Tolga-Cav/USB-Control-Panel-v1/PCB/Buttons/production/bom.csv

Designator | Footprint | Quantity | Value | LCSC Part #
C1, C2, C3, C4, C5, C6 | 1206 | 6 | 1uf
J1 | PinHeader_2x11_P2.54mm_Vertical | 1 | Conn_02x11_Odd_Even
S1, S2, S3, S4, S5, S6 | ULP12OAP1RSSCL1REDGRN | 6 | ULP12OAP1RSSCL1REDGRN
