Tolga-Cav/USB-Control-Panel-v1/PCB/Encoders/production/bom.csv

Designator | Footprint | Quantity | Value | LCSC Part #
J1 | PinHeader_1x05_P2.54mm_Vertical | 1 | Conn_01x05
U1, U2 | PEC12R4125FN0012 | 2 | PEC12R-4125F-N0012
