Tolga-Cav/USB-Control-Panel-v1/PCB/Main_Panel/production/bom.csv

Quantity | Value | Designator | Footprint | LCSC Part #
4 | 0.01uF | C1, C2, C3, C4 | 0805 | C1710
1 | TCA6424ARGJR | IC1 | QFN50P500X500X60-33N-D | C80692
12 | 10k | R1, R2, R3, R30, R31, R32, R33, R34, R35, R36, R37, R4 | 0805 | C17414
1 | 2.4k | R5 | 0805 | C17526
1 | TLC5947DAP | U2 | HTSSOP-32-1EP_6.1x11mm_P0.65mm_EP5.2x11mm_Mask4.11x4.36mm_ThermalVias | C2873022
