Tolga-Cav/USB-Control-Panel-v1/(list of files, cad)

Other CAD files:
CAD/3rd_Party_Parts/91862A525_Hex Panel Nut.ipt
CAD/3rd_Party_Parts/Bumpers.ipt
CAD/3rd_Party_Parts/Encoder_Knob.ipt
CAD/3rd_Party_Parts/Lighted_Buttons/Body1.ipt
CAD/3rd_Party_Parts/Lighted_Buttons/Body10.ipt
CAD/3rd_Party_Parts/Lighted_Buttons/Body2.ipt
CAD/3rd_Party_Parts/Lighted_Buttons/Body3.ipt
CAD/3rd_Party_Parts/Lighted_Buttons/Body4.ipt
CAD/3rd_Party_Parts/Lighted_Buttons/Body5.ipt
CAD/3rd_Party_Parts/Lighted_Buttons/Body6.ipt
CAD/3rd_Party_Parts/Lighted_Buttons/Body7.ipt
CAD/3rd_Party_Parts/Lighted_Buttons/Body8.ipt
CAD/3rd_Party_Parts/Lighted_Buttons/Body9.ipt
CAD/3rd_Party_Parts/Lighted_Buttons/Lighted_Buttons.iam
CAD/3rd_Party_Parts/Momentary Switch.ipt
CAD/3rd_Party_Parts/On-On Switch.ipt
CAD/3rd_Party_Parts/PDB12-H4201-103BF/PDB12-H4201-103BF.iam
CAD/3rd_Party_Parts/PDB12-H4201-103BF/µç×èÆ¬.ipt
CAD/3rd_Party_Parts/PDB12-H4201-103BF/¶Ë×Ó.ipt
CAD/3rd_Party_Parts/PDB12-H4201-103BF/Íâ¿Ç.ipt
CAD/3rd_Party_Parts/PDB12-H4201-103BF/ÖáÐÄ.ipt
CAD/3rd_Party_Parts/PEC12R-4125F-N0012.ipt
CAD/3rd_Party_Parts/Potentiometer Knob.ipt
CAD/3rd_Party_Parts/Switch Guard.ipt
CAD/Box.ipt
CAD/Buttons_PCB/Buttons.iam
CAD/Buttons_PCB/Buttons_PCB.ipt
CAD/Buttons_PCB/Buttons_copper.ipt
CAD/Buttons_PCB/Buttons_pad.ipt
CAD/Buttons_PCB/Buttons_silkscreen.ipt
CAD/Buttons_PCB/Buttons_soldermask.ipt
CAD/Buttons_PCB/Buttons_via.ipt
CAD/Encoders_PCB/Encoders.iam
CAD/Encoders_PCB/Encoders_PCB.ipt
CAD/Encoders_PCB/Encoders_copper.ipt
CAD/Encoders_PCB/Encoders_pad.ipt
CAD/Encoders_PCB/Encoders_silkscreen.ipt
CAD/Encoders_PCB/Encoders_soldermask.ipt
CAD/Faceplate.ipt
CAD/Full_Assembly.iam
CAD/Magnetic Faceplate Base.ipt
CAD/Magnetic Faceplate Top.ipt
CAD/Main_Panel_PCB/Main_Panel.iam
CAD/Main_Panel_PCB/Main_Panel_PCB.ipt
CAD/Main_Panel_PCB/Main_Panel_copper.ipt
CAD/Main_Panel_PCB/Main_Panel_silkscreen.ipt
CAD/Main_Panel_PCB/Main_Panel_soldermask.ipt
CAD/Main_Panel_PCB/Main_Panel_via.ipt
CAD/OldVersions/Box.0036.ipt
CAD/OldVersions/Faceplate.0027.ipt
CAD/OldVersions/Full_Assembly.0060.iam
CAD/OldVersions/Magnetic Faceplate Base.0038.ipt
CAD/OldVersions/Magnetic Faceplate Top.0039.ipt
CAD/Potentiometers_PCB/Potentiometers.iam
CAD/Potentiometers_PCB/Potentiometers_PCB.ipt
CAD/Potentiometers_PCB/Potentiometers_copper.ipt
CAD/Potentiometers_PCB/Potentiometers_pad.ipt
CAD/Potentiometers_PCB/Potentiometers_silkscreen.ipt
CAD/Potentiometers_PCB/Potentiometers_soldermask.ipt
CAD/Spacers/Button Spacer.ipt
CAD/Spacers/Encoder Spacer.ipt
CAD/Spacers/Header Spacers/Button Header Spacer 1.ipt
CAD/Spacers/Header Spacers/Encoder Header Spacer 1.ipt
CAD/Spacers/Header Spacers/OldVersions/Button Header Spacer 1.0002.ipt
CAD/Spacers/Header Spacers/OldVersions/Encoder Header Spacer 1.0001.ipt
CAD/Spacers/Header Spacers/OldVersions/Potentiometer Header Spacer 1.0001.ipt
CAD/Spacers/Header Spacers/Potentiometer Header Spacer 1.ipt
CAD/Spacers/M3 4mm Generic Standoff.ipt
CAD/Spacers/OldVersions/Button Header Spacer.0001.ipt
CAD/Spacers/OldVersions/Button Spacer.0004.ipt
CAD/Spacers/OldVersions/Encoder Spacer.0007.ipt
CAD/Spacers/OldVersions/Potentiometer Spacer.0005.ipt
CAD/Spacers/Potentiometer Spacer.ipt
CAD/Switches_PCB/Switches.iam
CAD/Switches_PCB/Switches_PCB.ipt
CAD/Switches_PCB/Switches_copper.ipt
CAD/Switches_PCB/Switches_pad.ipt
CAD/Switches_PCB/Switches_silkscreen.ipt
CAD/Switches_PCB/Switches_soldermask.ipt
