Tolga-Cav/USB-Control-Panel-v1/PCB/Main_Panel/Main_Panel.kicad_pcb

## KiCad design PCB/Main_Panel/Main_Panel.kicad_pcb (2025-12-21)

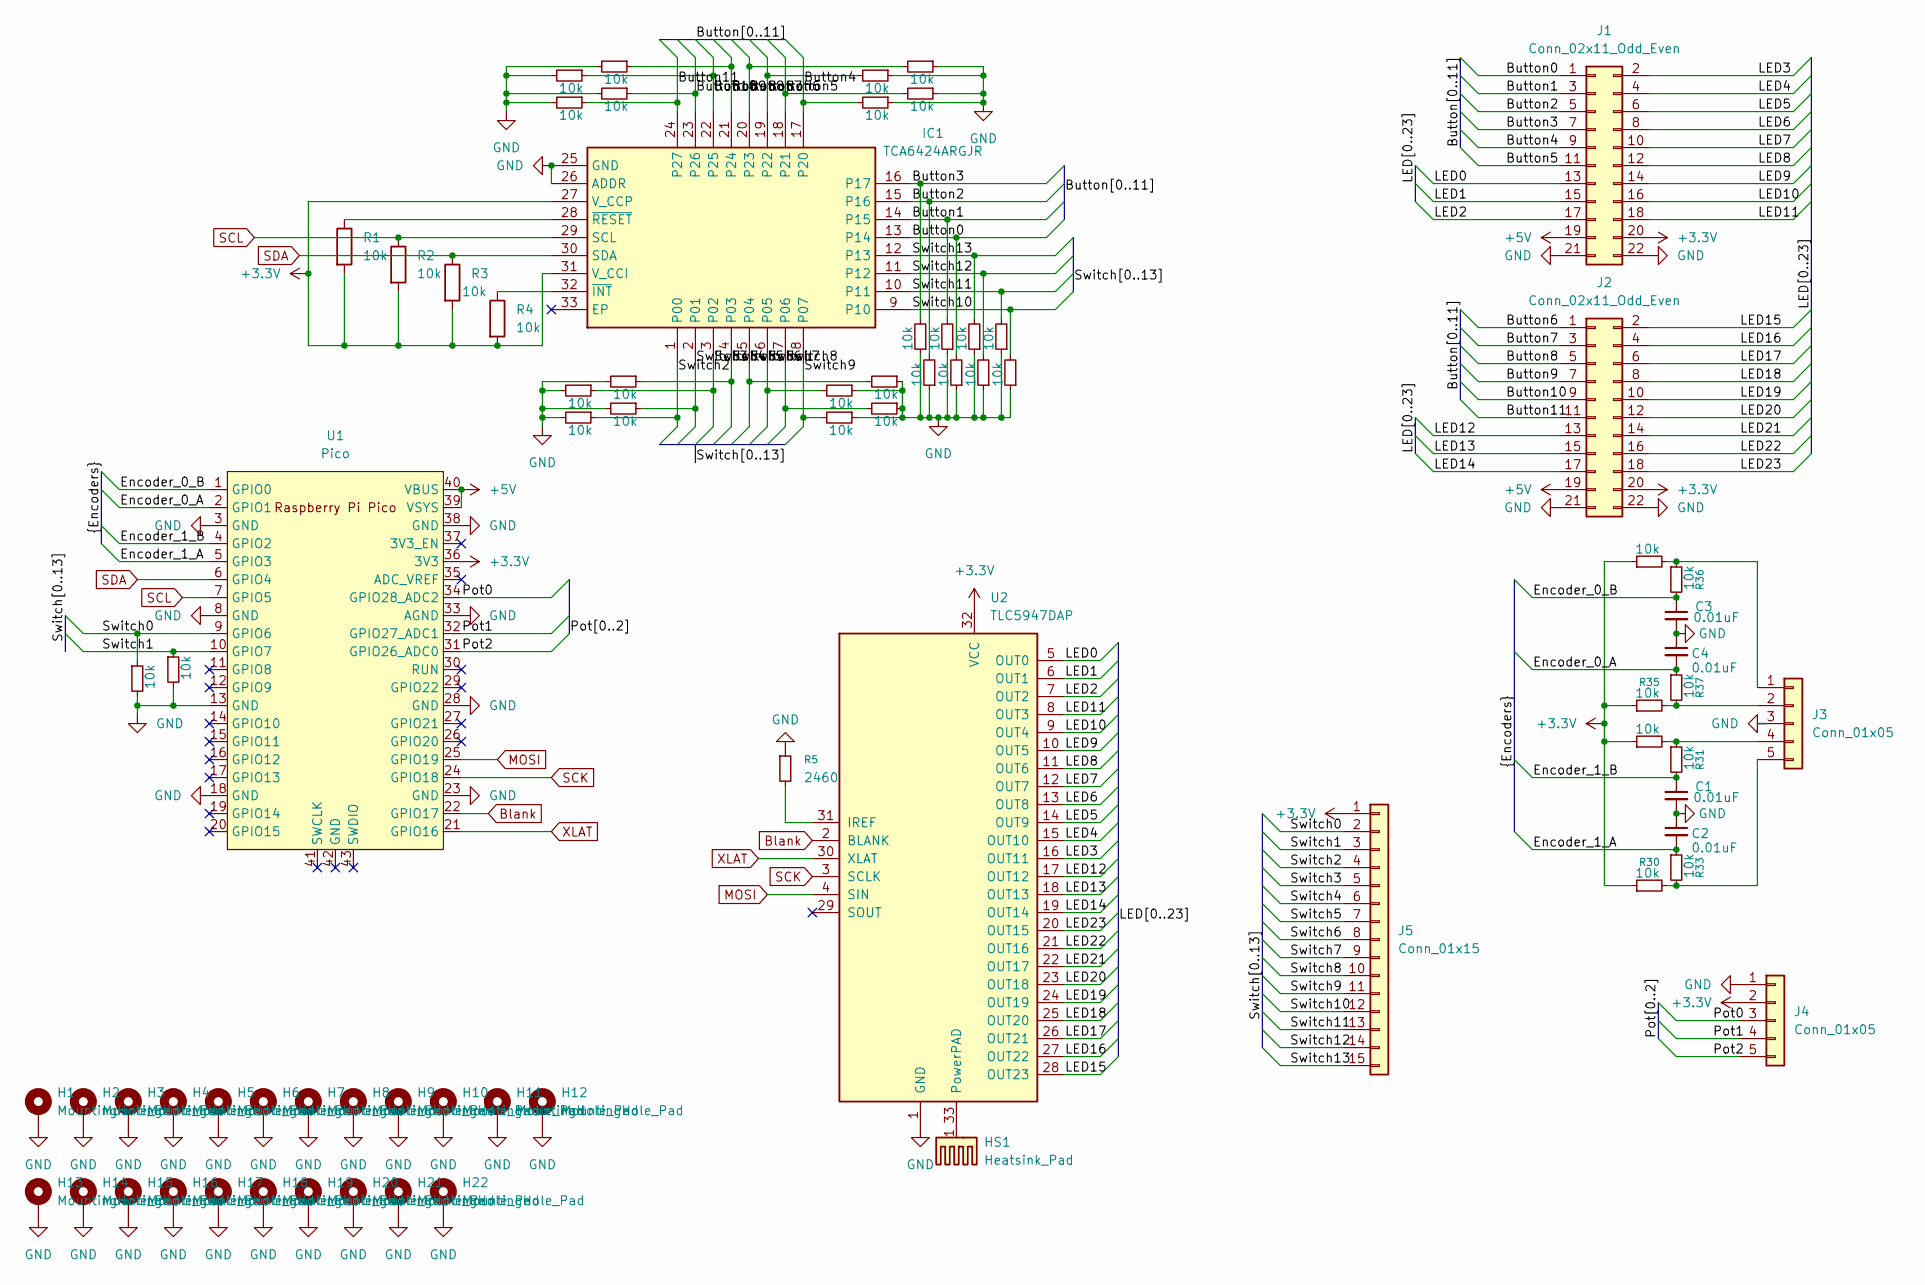
[picture p1: schematic Main_Panel.kicad_sch]

Parts:
C1, C2, C3, C4: 0.01uF; C_0805_2012Metric
H1, H2, H3, H4, H5, H6, H7, H8, H9, H10, H11, H12, H13, H14, H15, H16, H17, H18, H19, H20, H21, H22: MountingHole_Pad; MountingHole_3.2mm_M3_DIN965_Pad
HS1: Heatsink_Pad; Heat Sink
IC1: TCA6424ARGJR; QFN50P500X500X60-33N-D; Mouser Part Number 595-TCA6424ARGJR
J1, J2: Conn_02x11_Odd_Even; PinHeader_2x11_P2.54mm_Vertical
J3, J4: Conn_01x05; PinHeader_1x05_P2.54mm_Vertical
J5: Conn_01x15; PinHeader_1x15_P2.54mm_Vertical
R1, R2, R3, R4, R6, R7, R8, R9, R10, R11, R12, R13, R14, R15, R16, R17, R18, R19, R20, R21, R22, R23, R24, R25, R26, R27, R28, R29, R30, R31, R32, R33, R34, R35, R36, R37, R38, R39: 10k; R_0805_2012Metric
R5: 2460; R_0805_2012Metric
U1: Pico; RPi_Pico_SMD_TH
U2: TLC5947DAP; HTSSOP-32-1EP_6.1x11mm_P0.65mm_EP5.2x11mm_Mask4.11x4.36mm_T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

Connections:
+3.3V: IC1.27 (V_CCP), IC1.31 (V_CCI), J1.20, J2.20, J4.2, J5.1, R1.2, R2.2, R3.2, R4.2, R30.1, R32.1, R34.1, R35.1, U1.36 (3V3), U2.32 (VCC)
+5V: J1.19, J2.19, U1.39 (VSYS), U1.40 (VBUS)
/Button0: IC1.13 (P14), J1.1, R10.2
/Button1: IC1.14 (P15), J1.3, R7.2
/Button2: IC1.15 (P16), J1.5, R9.2
/Button3: IC1.16 (P17), J1.7, R6.2
/Button4: IC1.17 (P20), J1.9, R19.2
/Button5: IC1.18 (P21), J1.11, R21.2
/Button6: IC1.19 (P22), J2.1, R18.2
/Button7: IC1.20 (P23), J2.3, R20.2
/Button8: IC1.21 (P24), J2.5, R15.1
/Button9: IC1.22 (P25), J2.7, R14.1
/Button10: IC1.23 (P26), J2.9, R16.1
/Button11: IC1.24 (P27), J2.11, R17.1
/Encoder_0_A: C4.2, R37.1, U1.2 (GPIO1)
/Encoder_0_B: C3.1, R36.2, U1.1 (GPIO0)
/Encoder_1_A: C2.2, R33.1, U1.5 (GPIO3)
/Encoder_1_B: C1.1, R31.2, U1.4 (GPIO2)
/LED0: J1.13, U2.5 (OUT0)
/LED1: J1.15, U2.6 (OUT1)
/LED2: J1.17, U2.7 (OUT2)
/LED3: J1.2, U2.16 (OUT11)
/LED4: J1.4, U2.15 (OUT10)
/LED5: J1.6, U2.14 (OUT9)
/LED6: J1.8, U2.13 (OUT8)
/LED7: J1.10, U2.12 (OUT7)
/LED8: J1.12, U2.11 (OUT6)
/LED9: J1.14, U2.10 (OUT5)
/LED10: J1.16, U2.9 (OUT4)
/LED11: J1.18, U2.8 (OUT3)
/LED12: J2.13, U2.17 (OUT12)
/LED13: J2.15, U2.18 (OUT13)
/LED14: J2.17, U2.19 (OUT14)
/LED15: J2.2, U2.28 (OUT23)
/LED16: J2.4, U2.27 (OUT22)
/LED17: J2.6, U2.26 (OUT21)
/LED18: J2.8, U2.25 (OUT20)
/LED19: J2.10, U2.24 (OUT19)
/LED20: J2.12, U2.23 (OUT18)
/LED21: J2.14, U2.22 (OUT17)
/LED22: J2.16, U2.21 (OUT16)
/LED23: J2.18, U2.20 (OUT15)
/Pot0: J4.3, U1.34 (GPIO28_ADC2)
/Pot1: J4.4, U1.32 (GPIO27_ADC1)
/Pot2: J4.5, U1.31 (GPIO26_ADC0)
/Switch0: J5.2, R38.1, U1.9 (GPIO6)
/Switch1: J5.3, R39.1, U1.10 (GPIO7)
/Switch2: IC1.1 (P00), J5.4, R23.1
/Switch3: IC1.2 (P01), J5.5, R25.1
/Switch4: IC1.3 (P02), J5.6, R22.1
/Switch5: IC1.4 (P03), J5.7, R24.1
/Switch6: IC1.5 (P04), J5.8, R28.2
/Switch7: IC1.6 (P05), J5.9, R26.2
/Switch8: IC1.7 (P06), J5.10, R29.2
/Switch9: IC1.8 (P07), J5.11, R27.2
/Switch10: IC1.9 (P10), J5.12, R13.2
/Switch11: IC1.10 (P11), J5.13, R12.2
/Switch12: IC1.11 (P12), J5.14, R11.2
/Switch13: IC1.12 (P13), J5.15, R8.2
Blank: U1.22 (GPIO17), U2.2 (BLANK)
GND: C1.2, C2.1, C3.2, C4.1, H1.1, H2.1, H3.1, H4.1, H5.1, H6.1, H7.1, H8.1, H9.1, H10.1, H11.1, H12.1, H13.1, H14.1, H15.1, H16.1, H17.1, H18.1, H19.1, H20.1, H21.1, H22.1, IC1.25 (GND), IC1.26 (ADDR), J1.21, J1.22, J2.21, J2.22, J3.3, J4.1, R5.1, R6.1, R7.1, R8.1, R9.1, R10.1, R11.1, R12.1, R13.1, R14.2, R15.2, R16.2, R17.2, R18.1, R19.1, R20.1, R21.1, R22.2, R23.2, R24.2, R25.2, R26.1, R27.1, R28.1, R29.1, R38.2, R39.2, U1.3 (GND), U1.8 (GND), U1.13 (GND), U1.18 (GND), U1.23 (GND), U1.28 (GND), U1.33 (AGND), U1.38 (GND), U2.1 (GND)
MOSI: U1.25 (GPIO19), U2.4 (SIN)
unnamed: IC1.32 (~INT), R4.1
unnamed: IC1.28 (~RESET), R1.1
unnamed: J3.1, R34.2, R36.1
unnamed: J3.2, R35.2, R37.2
unnamed: J3.4, R31.1, R32.2
unnamed: J3.5, R30.2, R33.2
unnamed: R5.2, U2.31 (IREF)
unnamed: HS1.1, U2.33 (PowerPAD)
SCK: U1.24 (GPIO18), U2.3 (SCLK)
SCL: IC1.29 (SCL), R2.1, U1.7 (GPIO5)
SDA: IC1.30 (SDA), R3.1, U1.6 (GPIO4)
XLAT: U1.21 (GPIO16), U2.30 (XLAT)

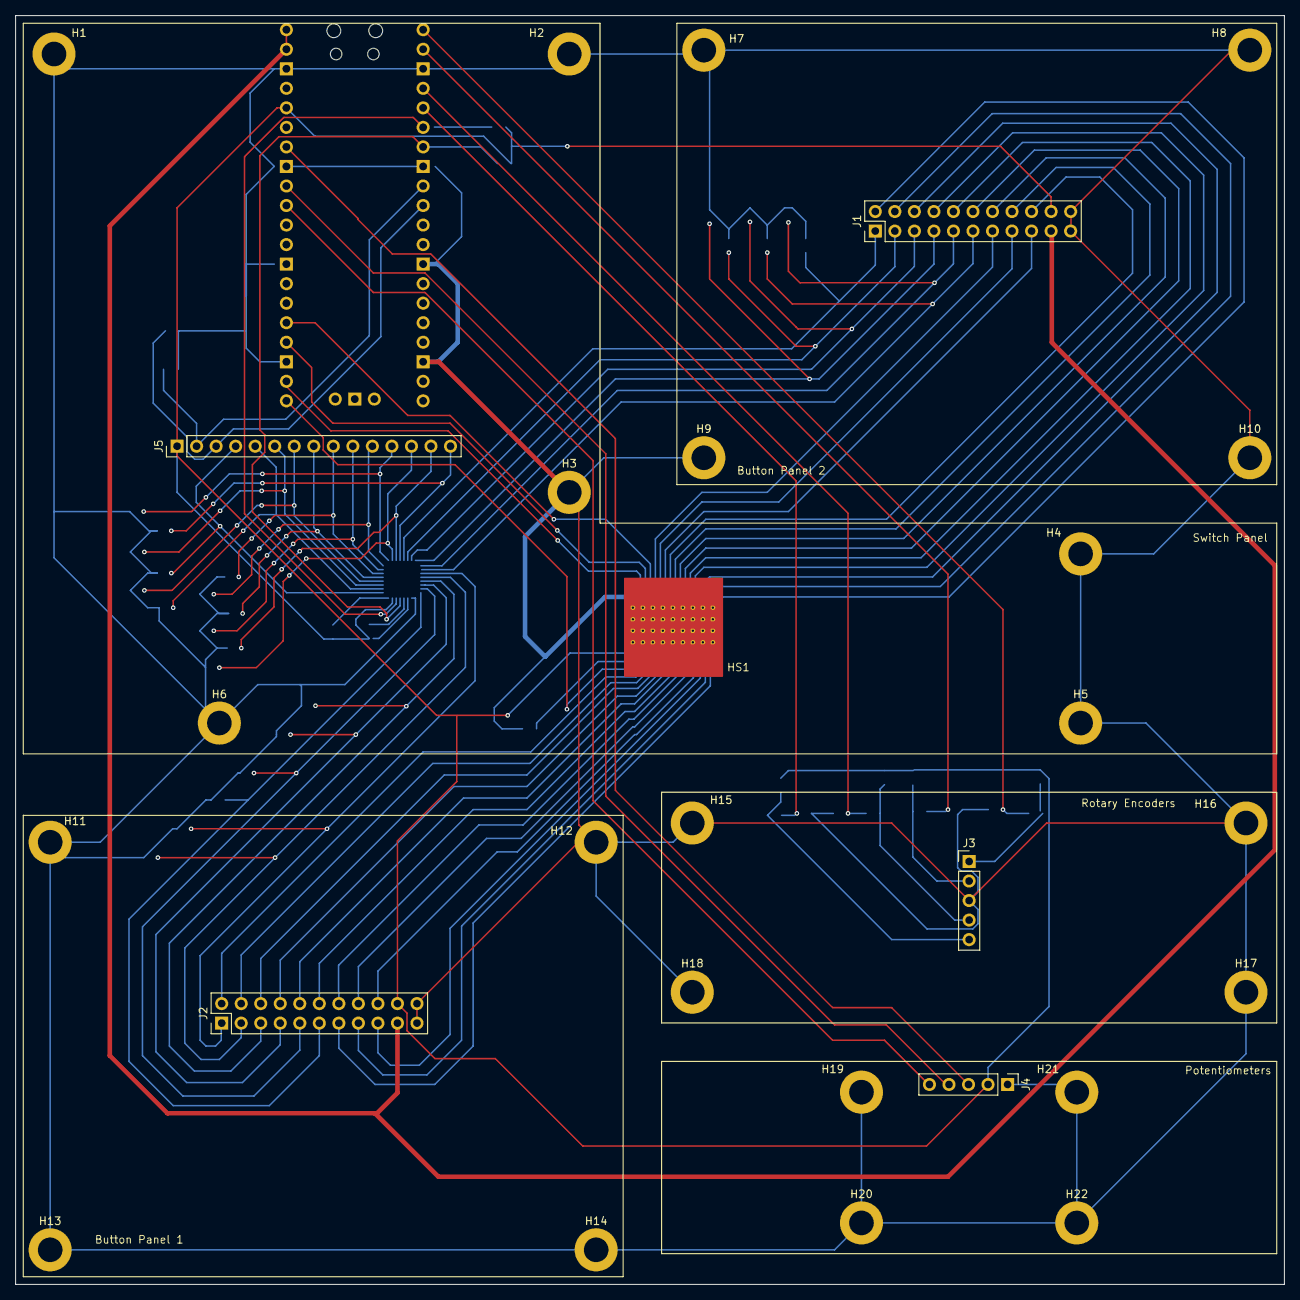
[picture p2: board Main_Panel.kicad_pcb from above]

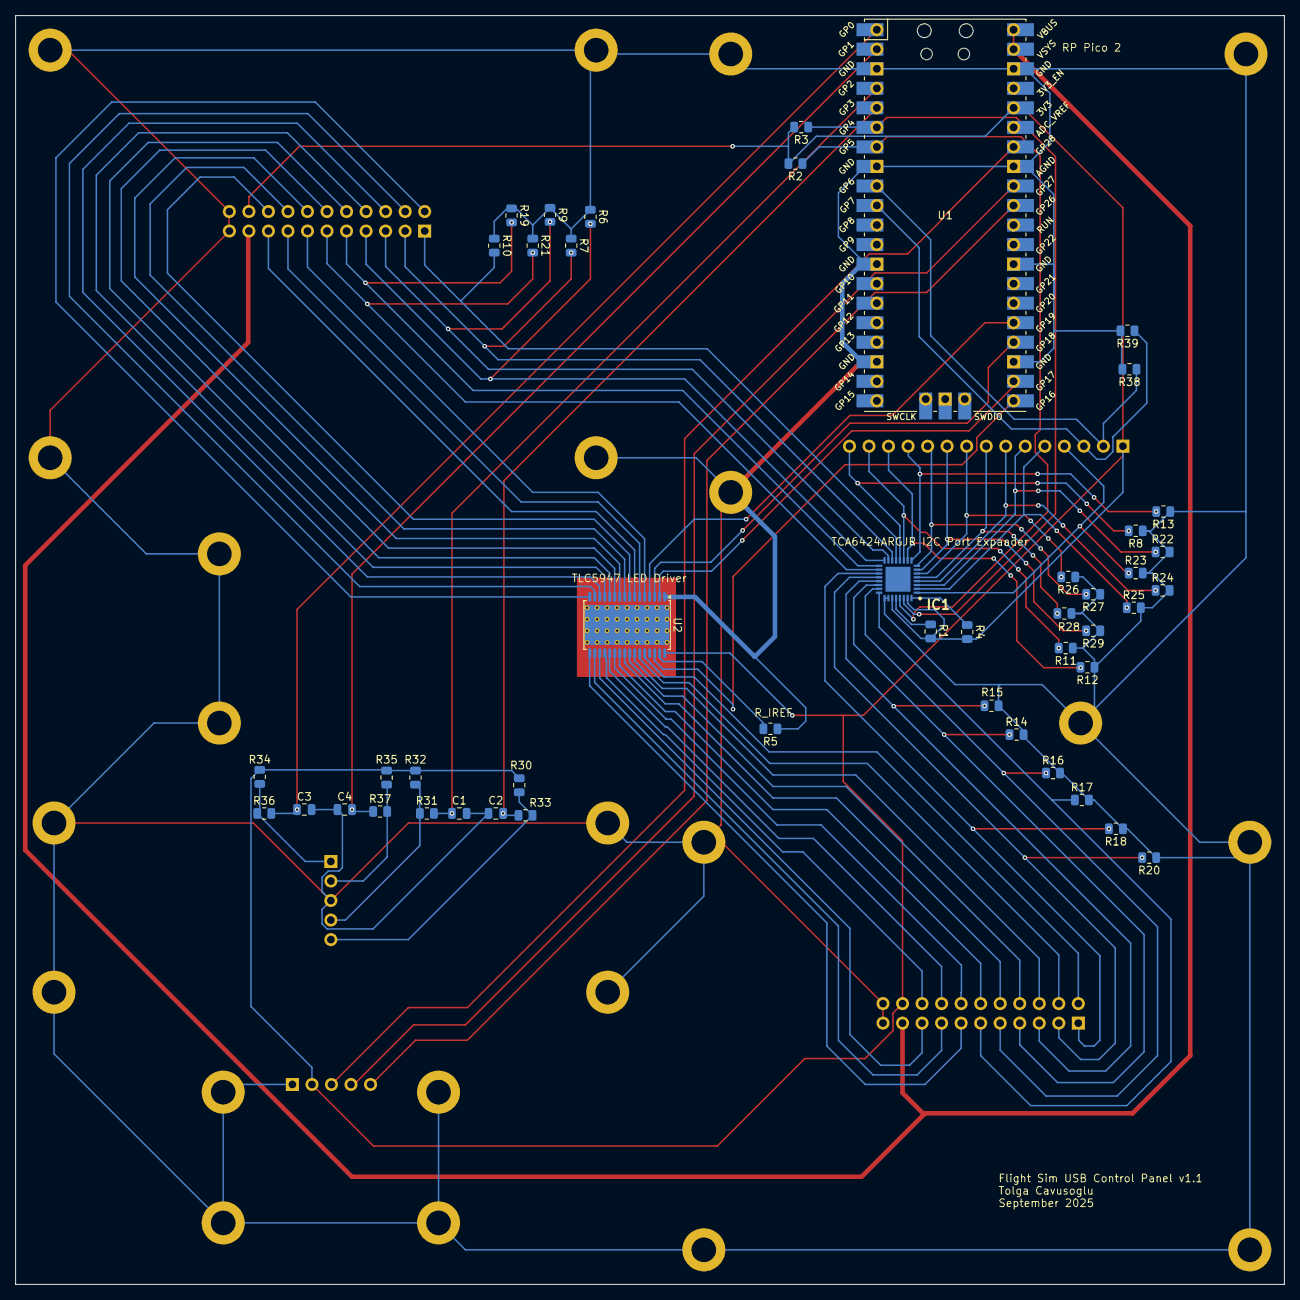
[picture p3: board Main_Panel.kicad_pcb from below]

Board: 2 copper layers, 165.0 x 165.0 mm, 74 parts (46 on the bottom side), 74 nets.
