Tolga-Cav/USB-Control-Panel-v1/PCB/Potentiometers/Potentiometers.kicad_pcb

## KiCad design PCB/Potentiometers/Potentiometers.kicad_pcb (2025-12-19)

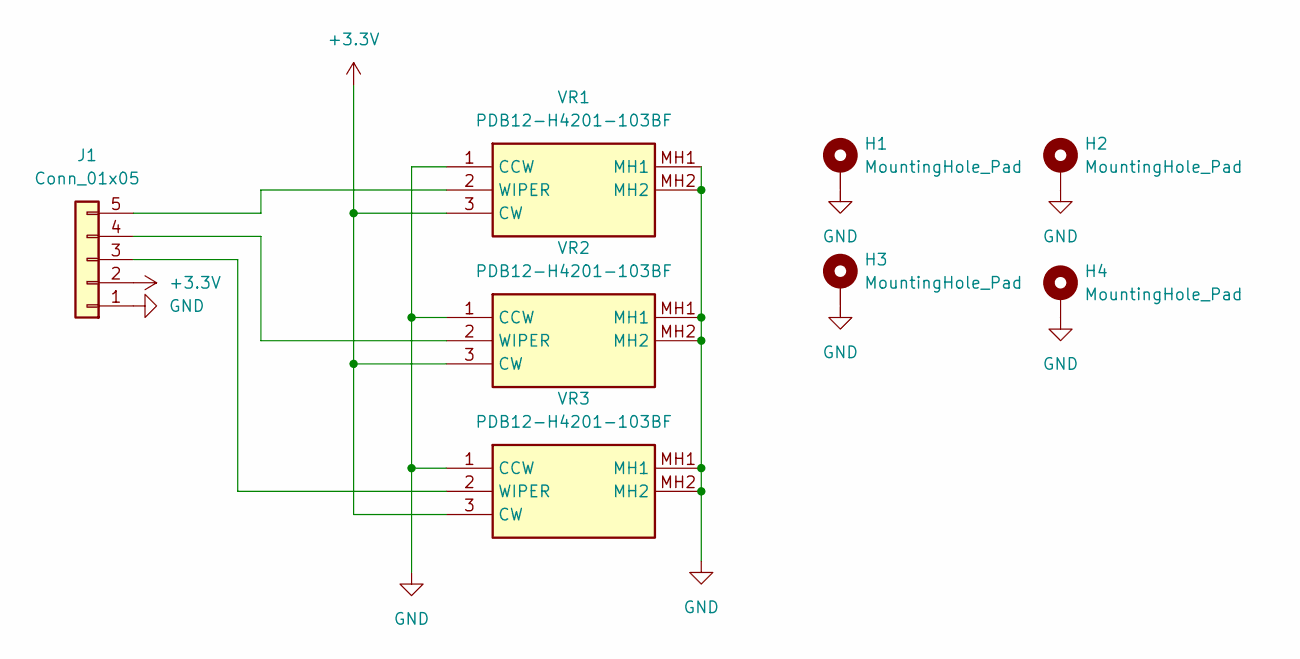
[picture p4: schematic Potentiometers.kicad_sch]

Parts:
H1, H2, H3, H4: MountingHole_Pad; MountingHole_3.2mm_M3_DIN965_Pad
J1: Conn_01x05; PinSocket_1x05_P2.54mm_Vertical
VR1, VR2, VR3: PDB12-H4201-103BF; PDB12H4201103BF; Mouser Part Number 652-PDB12-H4201103BF

Connections:
+3.3V: J1.2, VR1.3 (CW), VR2.3 (CW), VR3.3 (CW)
GND: H1.1, H2.1, H3.1, H4.1, J1.1, VR1.1 (CCW), VR1.MH1, VR1.MH2, VR2.1 (CCW), VR2.MH1, VR2.MH2, VR3.1 (CCW), VR3.MH1, VR3.MH2
unnamed: J1.3, VR3.2 (WIPER)
unnamed: J1.4, VR2.2 (WIPER)
unnamed: J1.5, VR1.2 (WIPER)

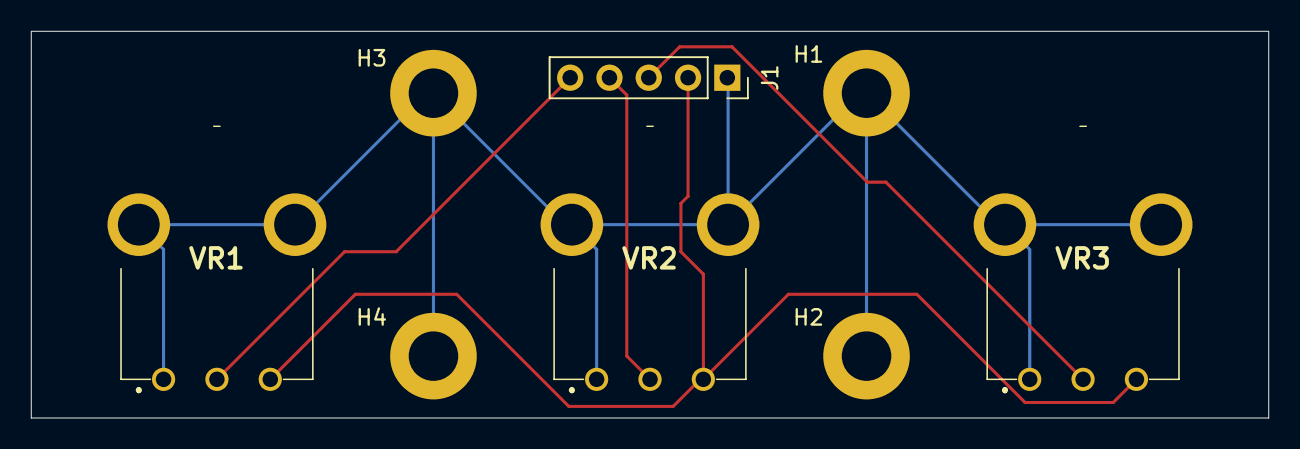
[picture p5: board Potentiometers.kicad_pcb from above]

Board: 2 copper layers, 80.0 x 25.0 mm, 8 parts (0 on the bottom side), 5 nets.
