Tolga-Cav/USB-Control-Panel-v1/PCB/Buttons/Buttons.kicad_pcb

## KiCad design PCB/Buttons/Buttons.kicad_pcb (2025-12-18)

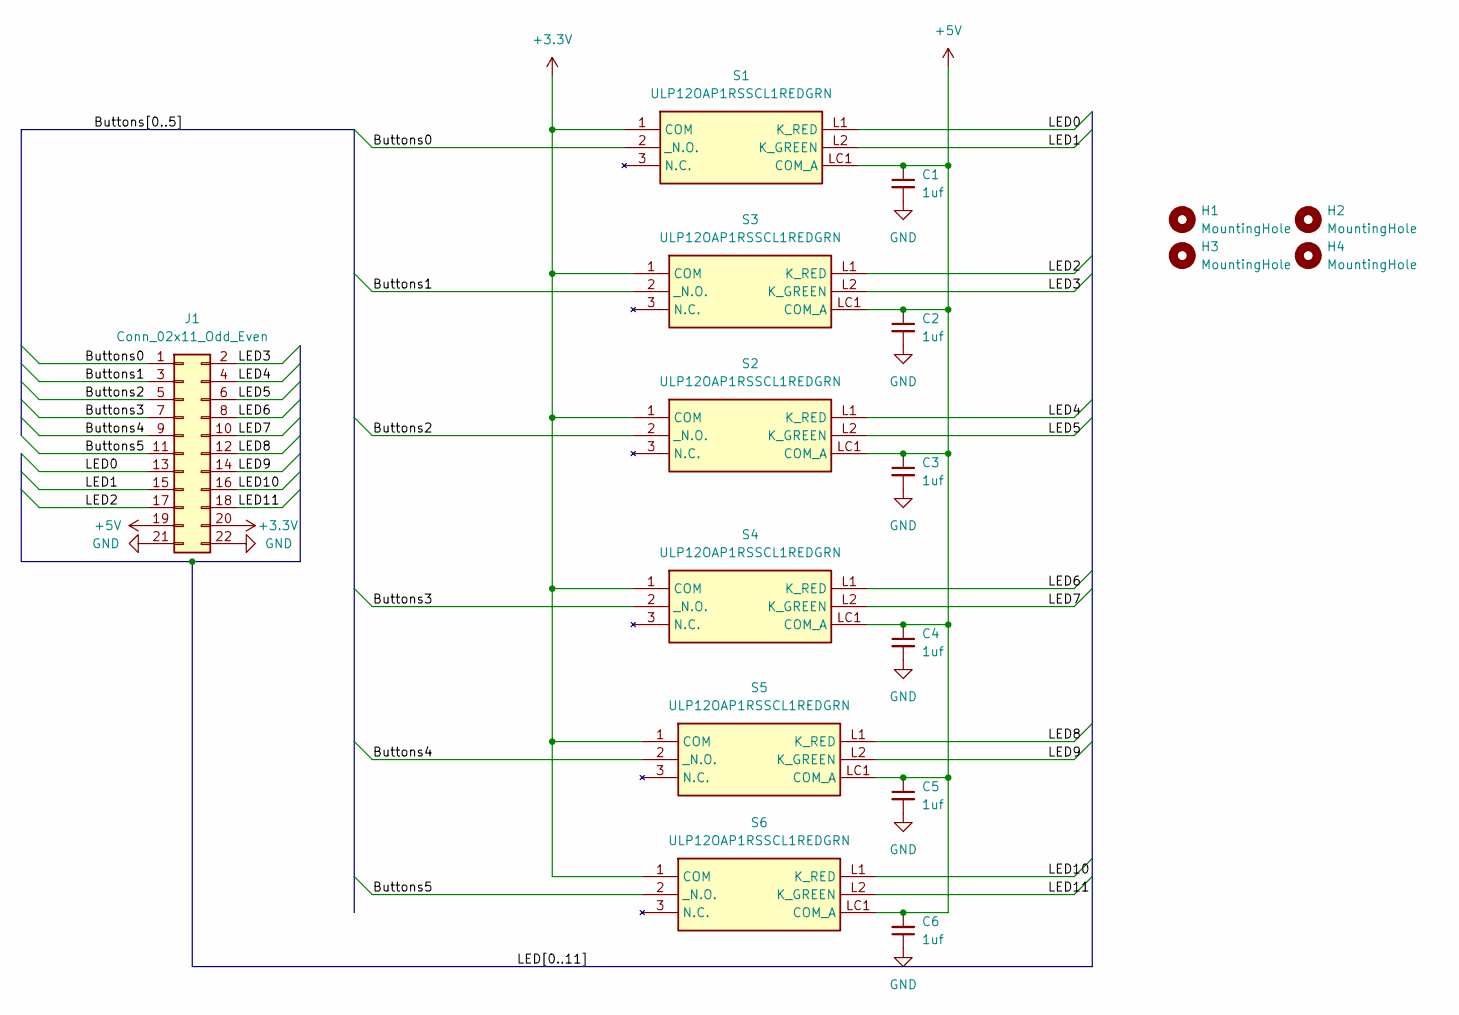
[picture p6: schematic Buttons.kicad_sch]

Parts:
C1, C2, C3, C4, C5, C6: 1uf; C_1206_3216Metric_Pad1.33x1.80mm_HandSolder
H1, H2, H3, H4: MountingHole; MountingHole_3.2mm_M3
J1: Conn_02x11_Odd_Even; PinHeader_2x11_P2.54mm_Vertical
S1, S2, S3, S4, S5, S6: ULP12OAP1RSSCL1REDGRN; Mouser Part Number 612-UP1RSSCL1REDGRN

Connections:
+3.3V: J1.20, S1.1 (COM), S2.1 (COM), S3.1 (COM), S4.1 (COM), S5.1 (COM), S6.1 (COM)
+5V: C1.1, C2.1, C3.1, C4.1, C5.1, C6.2, J1.19, S1.LC1 (COM_A), S2.LC1 (COM_A), S3.LC1 (COM_A), S4.LC1 (COM_A), S5.LC1 (COM_A), S6.LC1 (COM_A)
/Buttons0: J1.1, S1.2 (_N.O.)
/Buttons1: J1.3, S3.2 (_N.O.)
/Buttons2: J1.5, S2.2 (_N.O.)
/Buttons3: J1.7, S4.2 (_N.O.)
/Buttons4: J1.9, S5.2 (_N.O.)
/Buttons5: J1.11, S6.2 (_N.O.)
/LED0: J1.13, S1.L1 (K_RED)
/LED1: J1.15, S1.L2 (K_GREEN)
/LED2: J1.17, S3.L1 (K_RED)
/LED3: J1.2, S3.L2 (K_GREEN)
/LED4: J1.4, S2.L1 (K_RED)
/LED5: J1.6, S2.L2 (K_GREEN)
/LED6: J1.8, S4.L1 (K_RED)
/LED7: J1.10, S4.L2 (K_GREEN)
/LED8: J1.12, S5.L1 (K_RED)
/LED9: J1.14, S5.L2 (K_GREEN)
/LED10: J1.16, S6.L1 (K_RED)
/LED11: J1.18, S6.L2 (K_GREEN)
GND: C1.2, C2.2, C3.2, C4.2, C5.2, C6.1, J1.21, J1.22

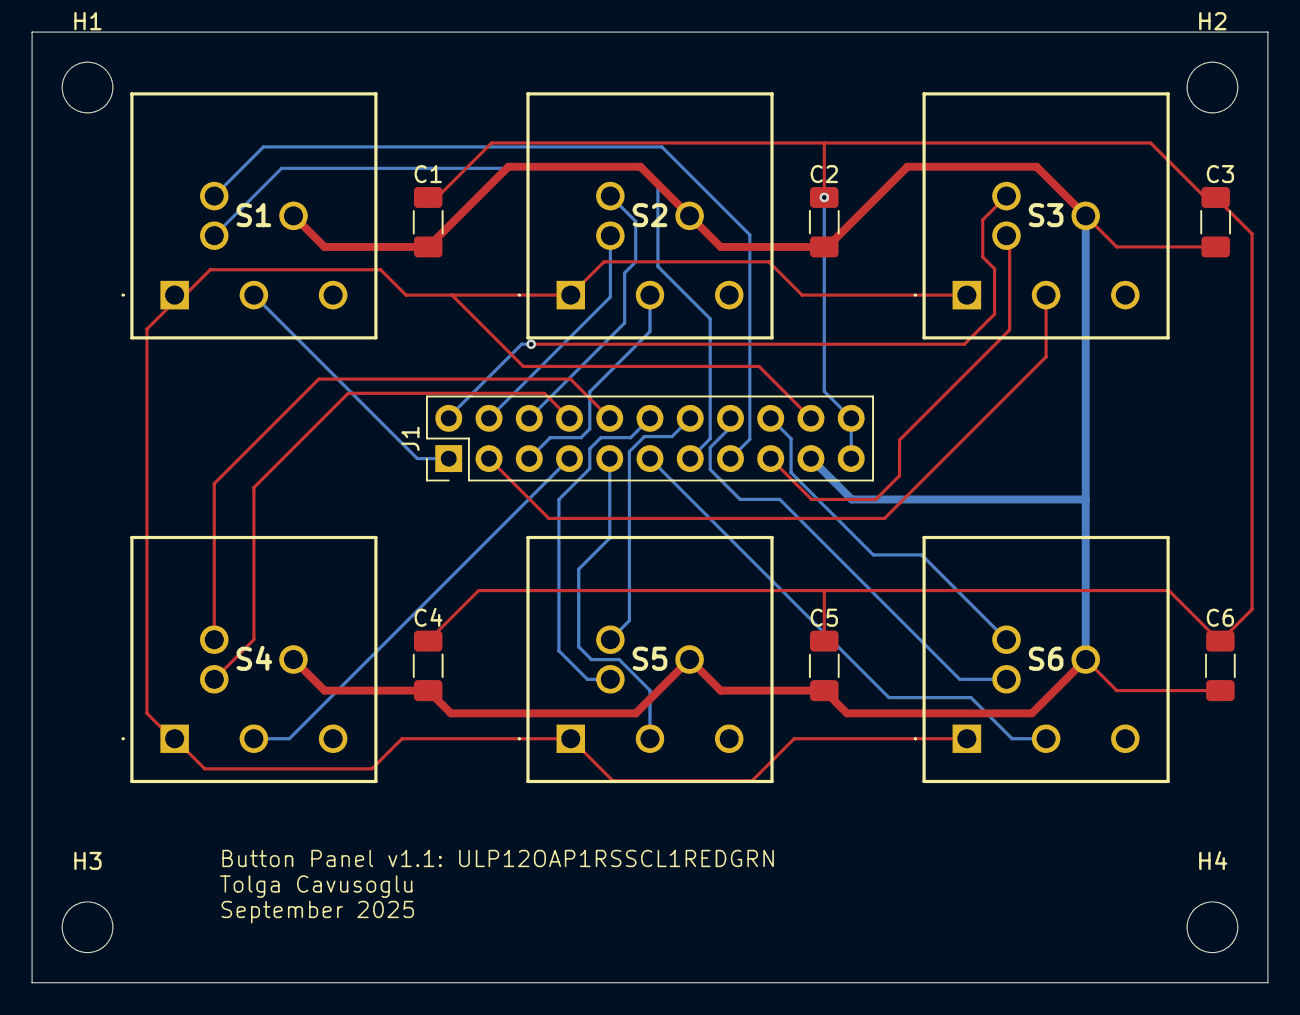
[picture p7: board Buttons.kicad_pcb from above]

Board: 2 copper layers, 78.0 x 60.0 mm, 17 parts (0 on the bottom side), 21 nets.
