Tolga-Cav/USB-Control-Panel-v1/PCB/Switches/Switches.kicad_pcb

## KiCad design PCB/Switches/Switches.kicad_pcb (2025-09-30)

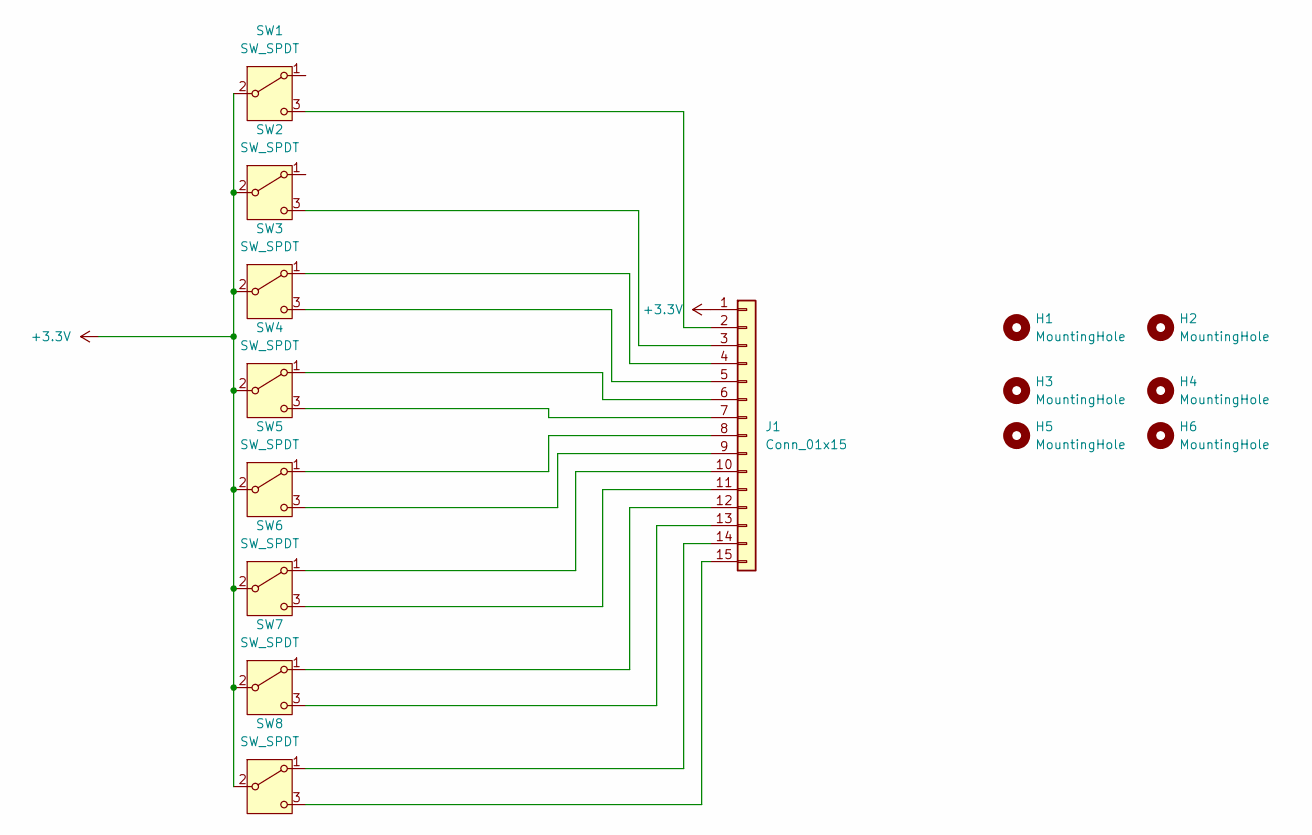
[picture p8: schematic Switches.kicad_sch]

Parts:
H1, H2, H3, H4, H5, H6: MountingHole; MountingHole_3.2mm_M3
J1: Conn_01x15; PinHeader_1x15_P2.54mm_Vertical
SW1, SW2, SW3, SW4, SW5, SW6, SW7, SW8: SW_SPDT; 100SP4T8B13VS2REH

Connections:
+3.3V: J1.1, SW1.2 (B), SW2.2 (B), SW3.2 (B), SW4.2 (B), SW5.2 (B), SW6.2 (B), SW7.2 (B), SW8.2 (B)
unnamed: J1.2, SW1.3 (C)
unnamed: J1.3, SW2.3 (C)
unnamed: J1.4, SW3.1 (A)
unnamed: J1.5, SW3.3 (C)
unnamed: J1.6, SW4.1 (A)
unnamed: J1.7, SW4.3 (C)
unnamed: J1.8, SW5.1 (A)
unnamed: J1.9, SW5.3 (C)
unnamed: J1.10, SW6.1 (A)
unnamed: J1.11, SW6.3 (C)
unnamed: J1.12, SW7.1 (A)
unnamed: J1.13, SW7.3 (C)
unnamed: J1.14, SW8.1 (A)
unnamed: J1.15, SW8.3 (C)

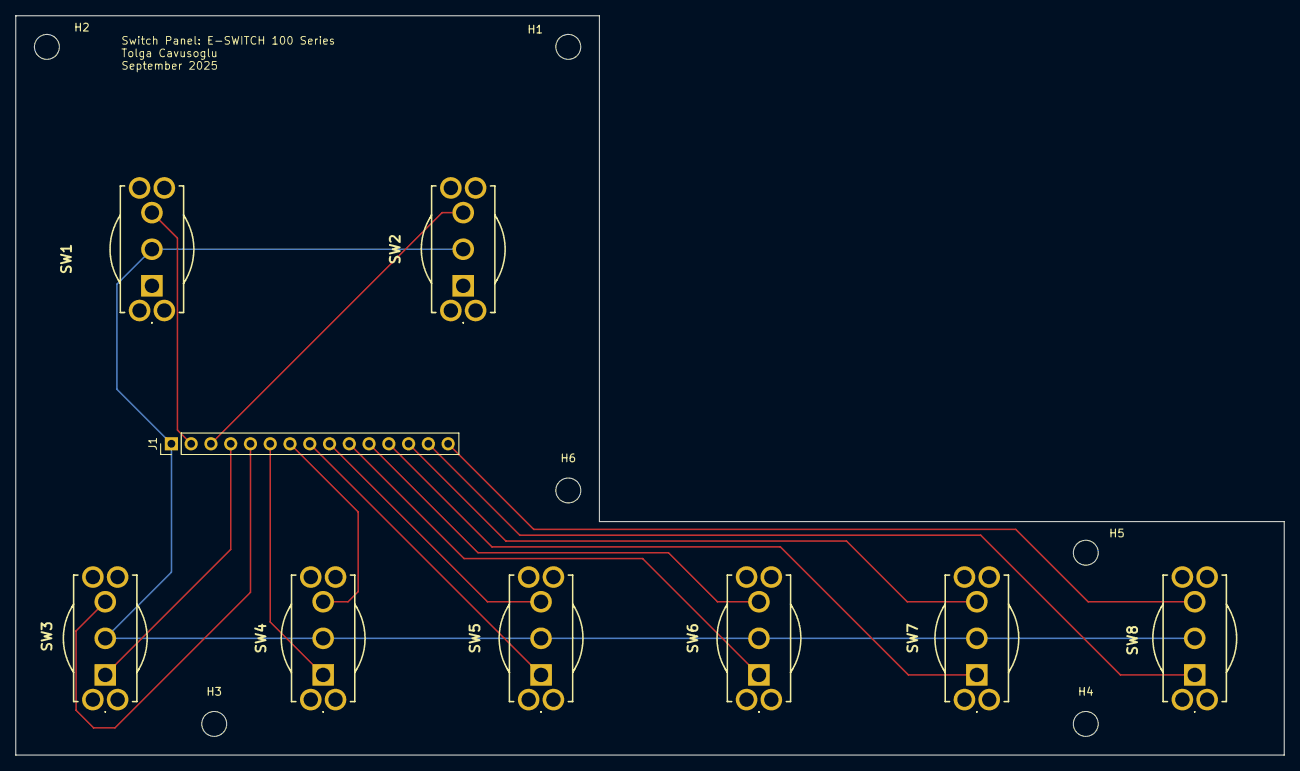
[picture p9: board Switches.kicad_pcb from above]

Board: 2 copper layers, 163.0 x 95.0 mm, 15 parts (0 on the bottom side), 15 nets.
