Tolga-Cav/USB-Control-Panel-v1/PCB/Encoders/Encoders.kicad_pcb

## KiCad design PCB/Encoders/Encoders.kicad_pcb (2025-09-30)

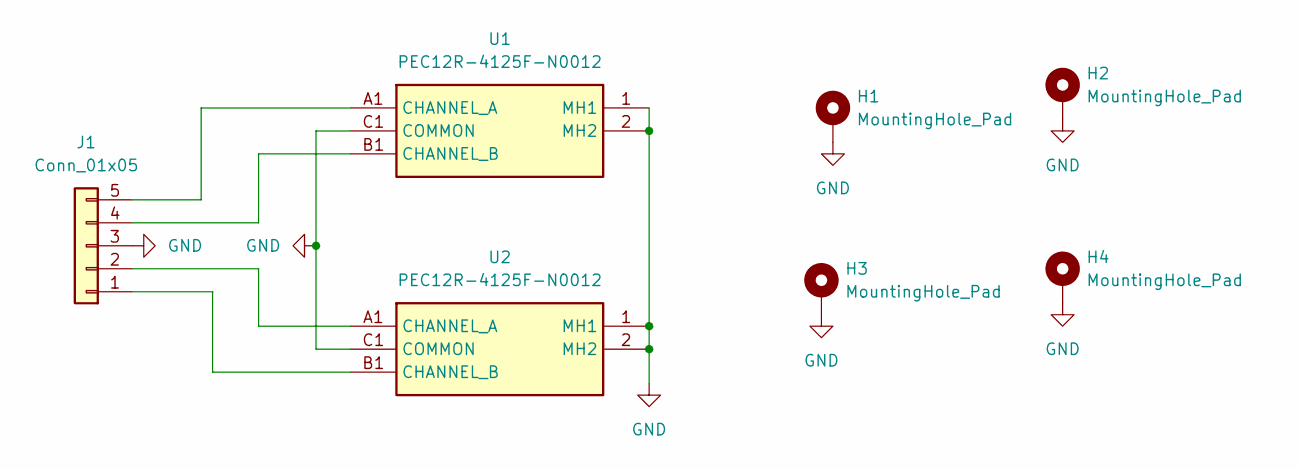
[picture p10: schematic Encoders.kicad_sch]

Parts:
H1, H2, H3, H4: MountingHole_Pad; MountingHole_3.2mm_M3_DIN965_Pad
J1: Conn_01x05; PinHeader_1x05_P2.54mm_Vertical
U1, U2: PEC12R-4125F-N0012; PEC12R4125FN0012; Mouser Part Number 652-PEC12R-4125F-N12

Connections:
GND: H1.1, H2.1, H3.1, H4.1, J1.3, U1.1 (MH1), U1.2 (MH2), U1.C1 (COMMON), U2.1 (MH1), U2.2 (MH2), U2.C1 (COMMON)
unnamed: J1.1, U2.B1 (CHANNEL_B)
unnamed: J1.2, U2.A1 (CHANNEL_A)
unnamed: J1.4, U1.B1 (CHANNEL_B)
unnamed: J1.5, U1.A1 (CHANNEL_A)

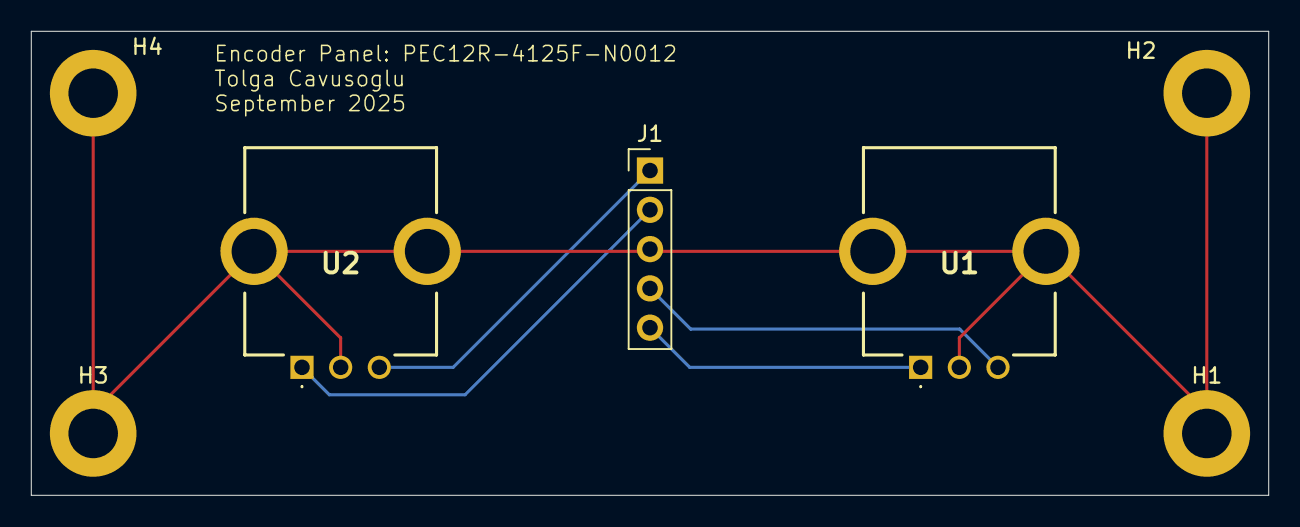
[picture p11: board Encoders.kicad_pcb from above]

Board: 2 copper layers, 80.0 x 30.0 mm, 7 parts (0 on the bottom side), 5 nets.
