Tolga-Cav/USB-Control-Panel-v1/(commit log)

2025-09-08 Added Cad files and created projects for all sub pcbs
    [Body1.ipt, Body10.ipt, Body2.ipt, Body3.ipt, Body4.ipt, Body5.ipt, Body6.ipt, Body7.ipt]
2025-09-09 Fill kicad libraries
    Finished the kicad symbol and footprint libraries and linked them together so everything works as intended.
    [Full_Assembly.0004.iam, Full_Assembly.0005.iam, Full_Assembly.iam, Main_Panel.kicad_pcb, Main_Panel.kicad_sch, PDB12-H4201-103BF.stp, PEC12R-4125F-N0012.stp]
2025-09-15 PCB Designs
    [Buttons.kicad_pcb, Buttons.kicad_sch, Encoders.kicad_pcb, Encoders.kicad_sch, Main_Panel.kicad_pcb, Main_Panel.kicad_sch, Potentiometers.kicad_pcb, Potentiometers.kicad_sch]
2025-09-15 Begin CAD
    [Box.0005.ipt, Box.ipt, Faceplate.0001.ipt, Faceplate.0012.ipt, Faceplate.ipt, Full_Assembly.0005.iam, Full_Assembly.0011.iam, Full_Assembly.iam]
2025-09-30 PCB Manufacturing Files and Full CAD
    [91862A525_Hex Panel Nut.ipt, Box.0005.ipt, Box.0036.ipt, Box.ipt, Button Header Spacer 1.0002.ipt, Button Header Spacer 1.ipt, Button Header Spacer.0001.ipt, Button Spacer.0004.ipt]
2025-12-18 Update main and button pcbs to fix errors with v1.0
    Added pull downs to gpio expander and changed header footprint
    [Buttons.kicad_pcb, Buttons.kicad_sch, Main_Panel.kicad_pcb, Main_Panel.kicad_sch]
2025-12-19 Update CAD
    [Full_Assembly.0059.iam, Full_Assembly.0060.iam, Full_Assembly.iam]
2025-12-19 Update potentiometer panel
    Increase the pitch between the pins of the potentiometers to account for disagreement between footprint found online and actual component
    [Potentiometers.kicad_pcb]
2025-12-21 Add manufacturing files for v1.1
    [Main_Panel.kicad_pcb, Main_Panel.kicad_sch, bom.csv, bom_old.csv, bom_semi_old.csv, designators.csv, positions.csv, positions_old.csv]
